ArcticMeteor246/Annex-Engineering_User_Mods/Extruders/Ascender/churls-Ball_bearing_latch/Images/ISO.png

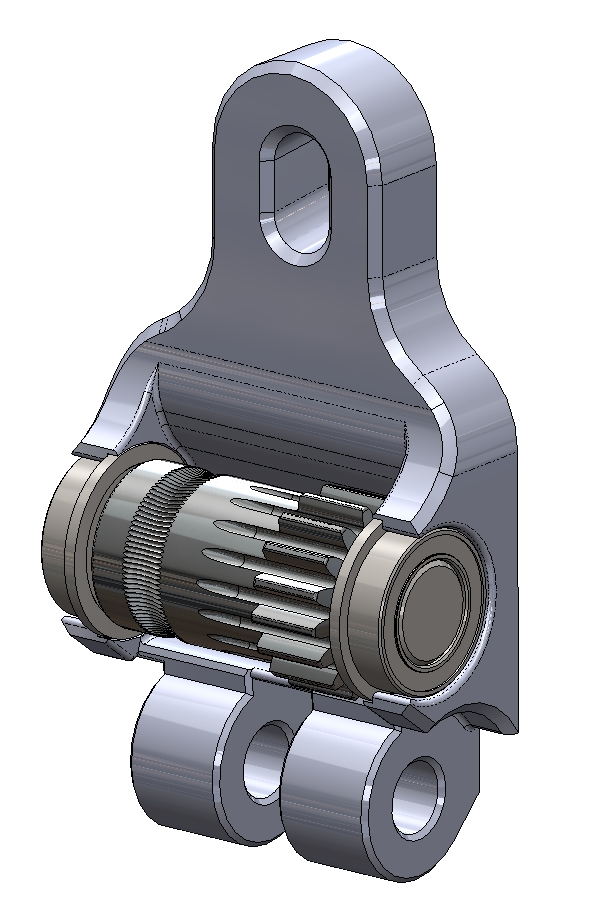
Extruders/Ascender/churls-Ball_bearing_latch/Images/ISO.png
