ArcticMeteor246/Annex-Engineering_User_Mods/Extruders/Ascender/churls-Fixed_idler_ascender/Images/ISO.png

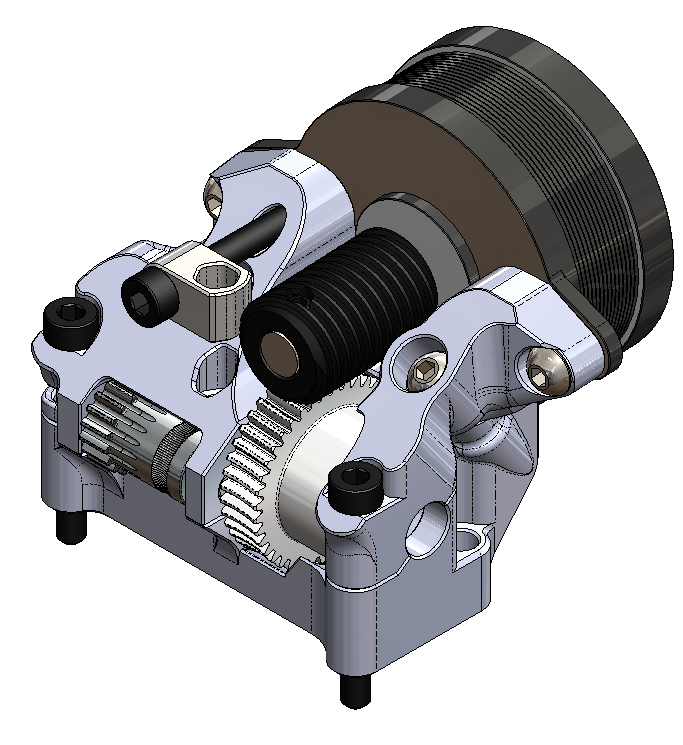
Extruders/Ascender/churls-Fixed_idler_ascender/Images/ISO.png
