ArcticMeteor246/Annex-Engineering_User_Mods/Extruders/Ascender/churls-Fixed_idler_ascender/Images/ISO_MR85.png

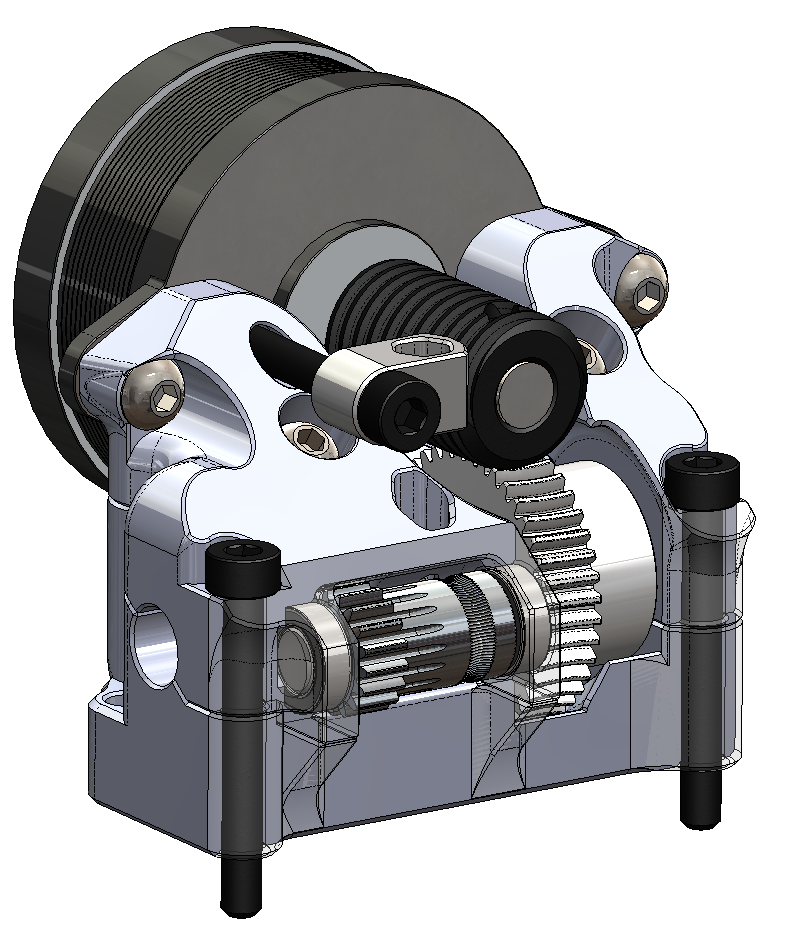
Extruders/Ascender/churls-Fixed_idler_ascender/Images/ISO_MR85.png
