ArcticMeteor246/Annex-Engineering_User_Mods/Extruders/Sherpa_Micro/Extruder_Mods/Churls_Fixed_Idler_Micro/Images/vzISO.png

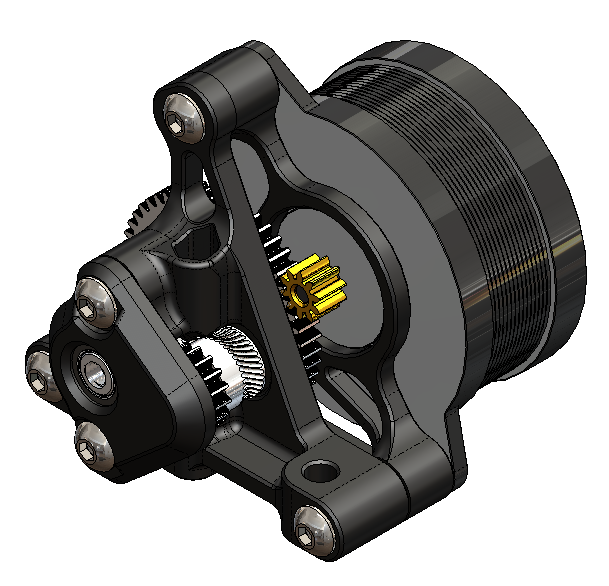
Extruders/Sherpa_Micro/Extruder_Mods/Churls_Fixed_Idler_Micro/Images/vzISO.png
