ArcticMeteor246/Annex-Engineering_User_Mods/Extruders/Sherpa_Mini/Extruder_Mods/Churls-Fixed_Idler_Mini/Images/vzISO.png

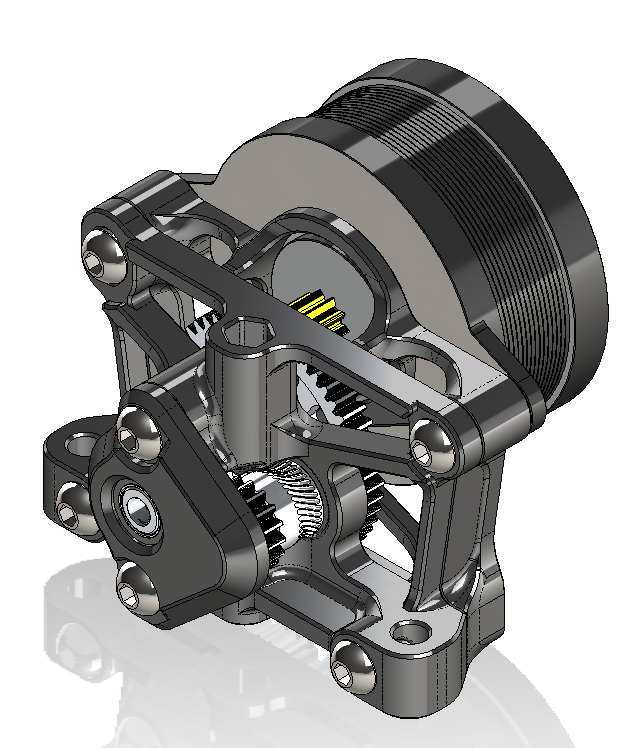
Extruders/Sherpa_Mini/Extruder_Mods/Churls-Fixed_Idler_Mini/Images/vzISO.png
