ArcticMeteor246/Annex-Engineering_User_Mods/Extruders/Sherpa_Mini/Toolheads/Churls-Chubby_E3/Images/Chubby+QuickDraw.png

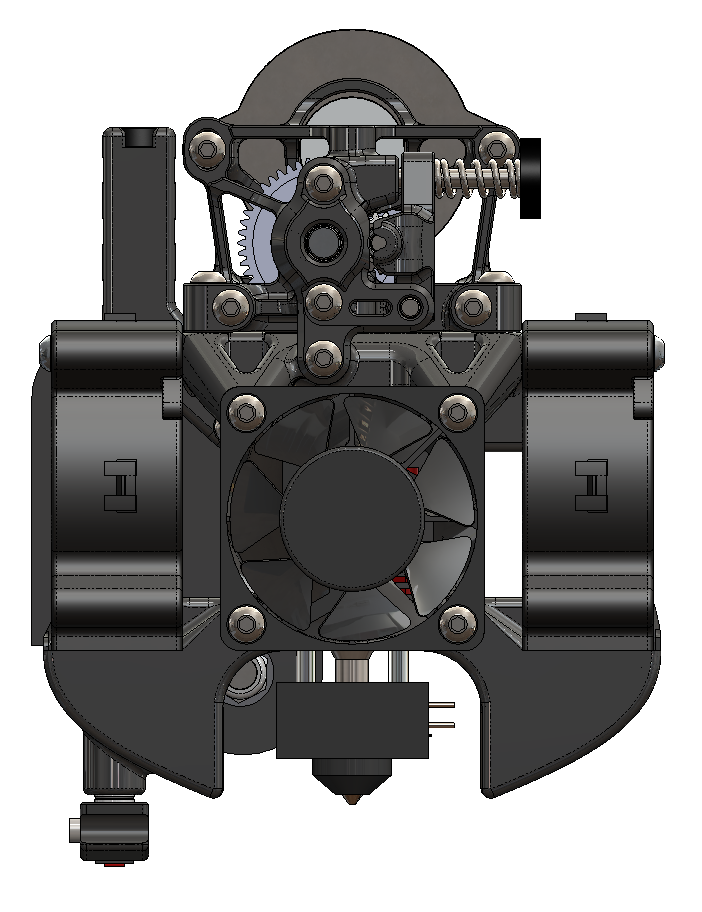
Extruders/Sherpa_Mini/Toolheads/Churls-Chubby_E3/Images/Chubby+QuickDraw.png
