ArcticMeteor246/Annex-Engineering_User_Mods/Extruders/Sherpa_Mini/Toolheads/Churls-Stiffy_E3/Images/QuickDraw_XY_Offset.png

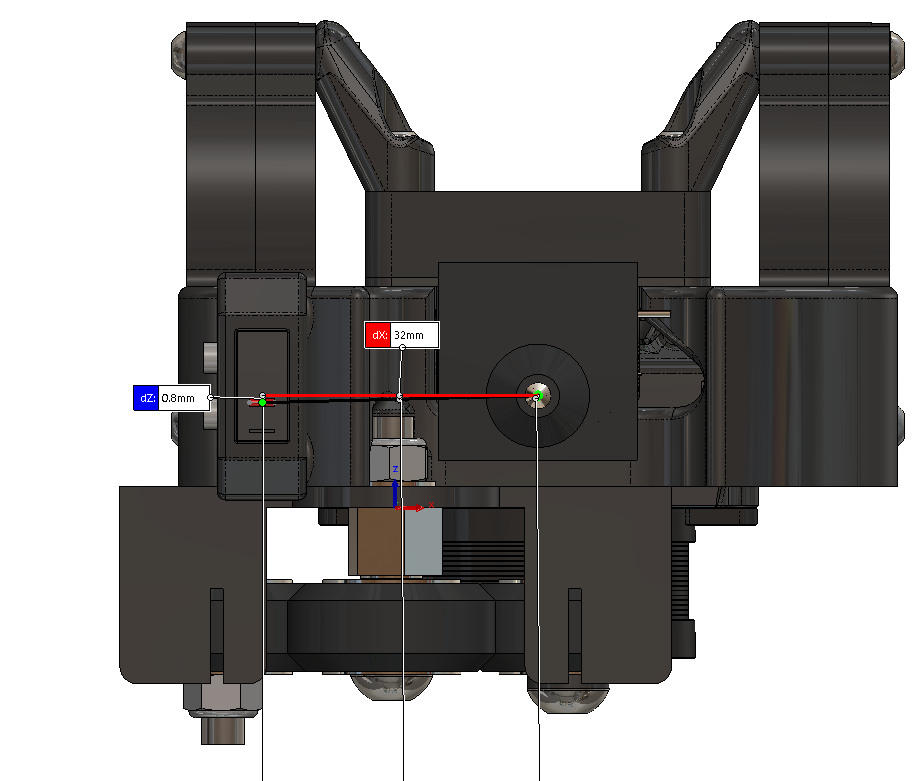
Extruders/Sherpa_Mini/Toolheads/Churls-Stiffy_E3/Images/QuickDraw_XY_Offset.png
