ArcticMeteor246/Annex-Engineering_User_Mods/Extruders/Ascender/churls-Ball_bearing_latch/CAD/mr85_ascender_latch.STEP

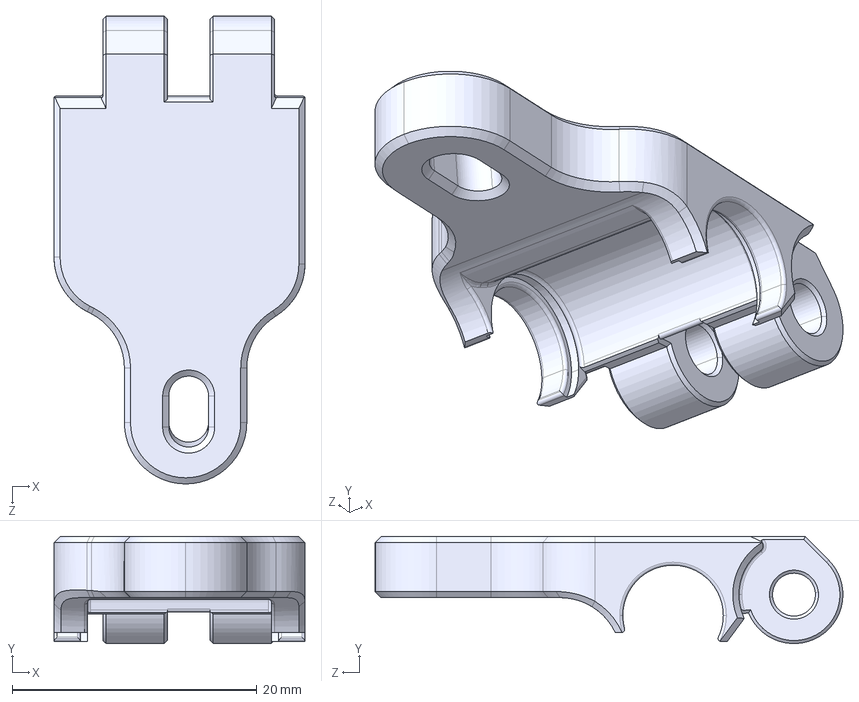
[picture p20: CAD file, 2023-04-30]
Extruders/Ascender/churls-Ball_bearing_latch/CAD/mr85_ascender_latch.STEP
20.5 x 8.74 x 38.2 mm
