ArcticMeteor246/Annex-Engineering_User_Mods/Extruders/Sherpa_Micro/Extruder_Mods/Churls_Fixed_Idler_Micro/STLs/Bondtech RIDGA/Sherpa_micro_housing_front.STL

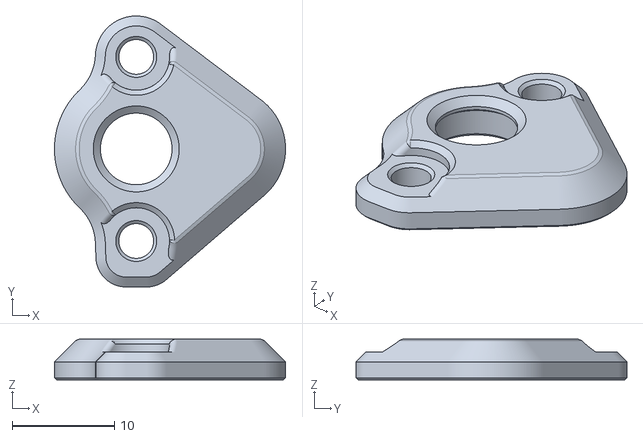
[picture p21: CAD file, 2023-04-30]
Extruders/Sherpa_Micro/Extruder_Mods/Churls_Fixed_Idler_Micro/STLs/Bondtech RIDGA/Sherpa_micro_housing_front.STL
22.6 x 26.5 x 4.00
