ArcticMeteor246/Annex-Engineering_User_Mods/Extruders/Sherpa_Micro/Extruder_Mods/Churls_Micro_RIDGA/STLs/Mellow vzRIDGA/Sherpa_micro_housing_front.STL

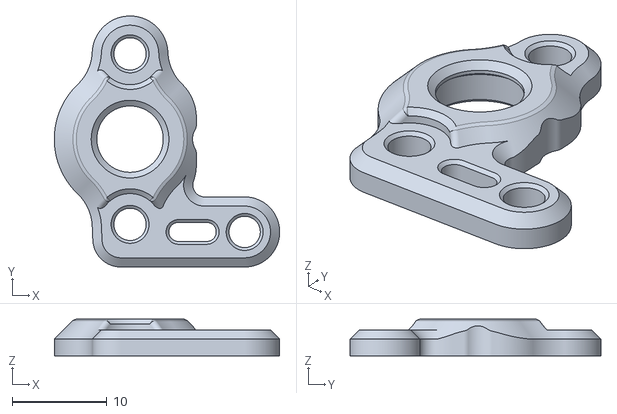
[picture p22: CAD file, 2023-04-30]
Extruders/Sherpa_Micro/Extruder_Mods/Churls_Micro_RIDGA/STLs/Mellow vzRIDGA/Sherpa_micro_housing_front.STL
23.8 x 26.5 x 3.90
