ArcticMeteor246/Annex-Engineering_User_Mods/Extruders/Sherpa_Mini/Extruder_Mods/Churls-Mini_RIDGA/STLs/Bondtech RIDGA/Additional Parts for 4x7x2.5 Bearings/RIDGA_Sherpa_housing_front_4x7x2.5_BRG.STL

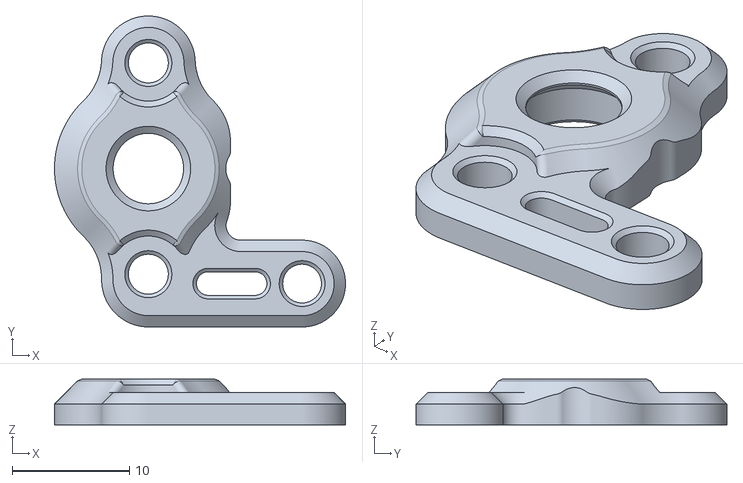
[picture p23: CAD file, 2023-04-30]
Extruders/Sherpa_Mini/Extruder_Mods/Churls-Mini_RIDGA/STLs/Bondtech RIDGA/Additional Parts for 4x7x2.5 Bearings/RIDGA_Sherpa_housing_front_4x7x2.5_BRG.STL
24.8 x 26.5 x 3.90
