ArcticMeteor246/Annex-Engineering_User_Mods/Extruders/Sherpa_Mini/Extruder_Mods/Churls-Mini_RIDGA/STLs/Bondtech RIDGA/Additional Parts for 4x8x3 Bearings/RIDGA_sherpa_mini_housing_front_k_4x8x3_BRG.STL

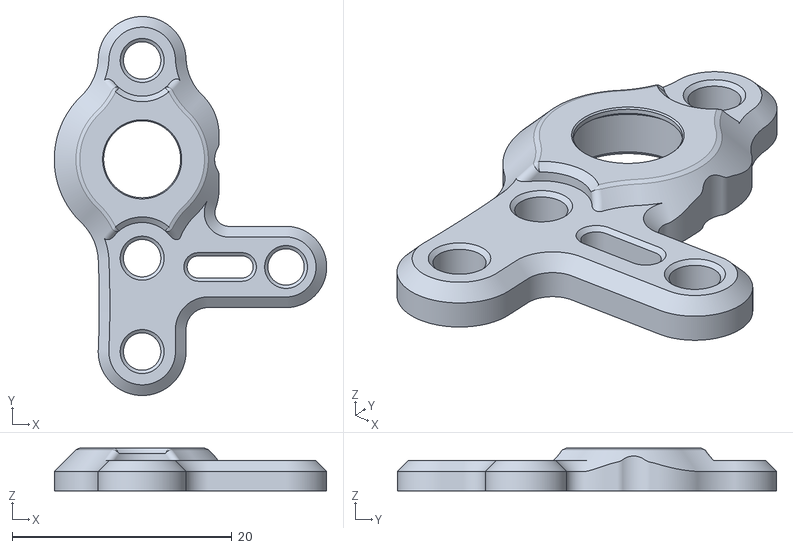
[picture p24: CAD file, 2023-04-30]
Extruders/Sherpa_Mini/Extruder_Mods/Churls-Mini_RIDGA/STLs/Bondtech RIDGA/Additional Parts for 4x8x3 Bearings/RIDGA_sherpa_mini_housing_front_k_4x8x3_BRG.STL
24.8 x 34.5 x 3.90
