ArcticMeteor246/Annex-Engineering_User_Mods/Extruders/Sherpa_Mini/Toolheads/Churls-Chubby_E3/CAD/Chubby.STEP

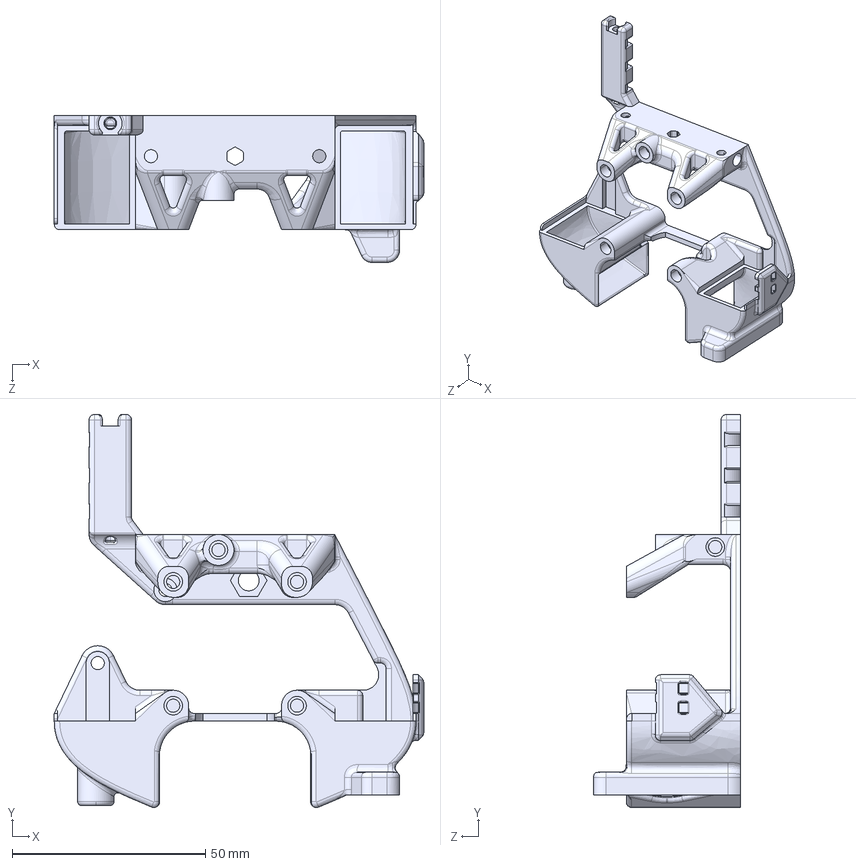
[picture p25: CAD file, 2023-04-30]
Extruders/Sherpa_Mini/Toolheads/Churls-Chubby_E3/CAD/Chubby.STEP
95.5 x 101.6 x 37.9 mm
