ArcticMeteor246/Annex-Engineering_User_Mods/Printers/K3/chkockle-Nozzle_Wiper_Beacon/CAD/Beacon_NozzleWiper.step

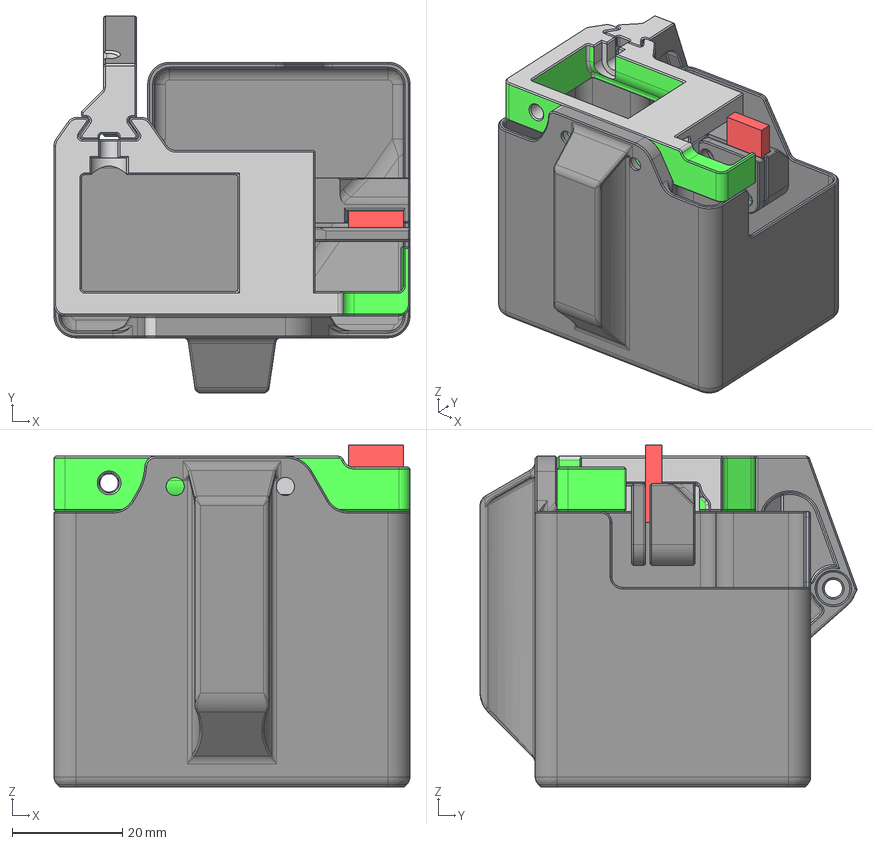
[picture p26: CAD file, 2023-04-30]
Printers/K3/chkockle-Nozzle_Wiper_Beacon/CAD/Beacon_NozzleWiper.step
64.6 x 68.4 x 62.0 mm
Nozzle Wiper Bracket V2^K3 Sherpa Mini Toolhead
6x3_Magnet x 10
Optional Thermistor
socket head cap screw_am(B18.3.1M - 3 x 0.5 x 8 Hex SHCS -- 8NHX) x 9
socket head cap screw_am(B18.3.1M - 3 x 0.5 x 30 Hex SHCS -- 18NHX)
socket button head cap screw_am(B18.3.4M - 3 x 0.5 x 8 SBHCS --N) x 2
socket head cap screw_am(B18.3.1M - 3 x 0.5 x 10 Hex SHCS -- 10NHX) x 3
socket head cap screw_am(B18.3.1M - 3 x 0.5 x 12 Hex SHCS -- 12NHX) x 3
socket head cap screw_am(B18.3.1M - 3 x 0.5 x 25 Hex SHCS -- 18NHX) x 2
94180A331_HEAT-SET INSERTS FOR PLASTICS x 13
93625A100_18-8 STAINLESS STEEL NYLON-INSERT LOCKNUT
Nozzle Wiper Base^K3 Sherpa Mini Toolhead
Nozzle Wiper Arm^K3 Sherpa Mini Toolhead
Nozzle Wiper Arm^K3 Sherpa Mini Toolhead (1)
Nozzle Wiper Arm^K3 Sherpa Mini Toolhead (2)
Purge Bucket V2^K3 Sherpa Mini Toolhead
