ArcticMeteor246/Annex-Engineering_User_Mods/Printers/K3/chkockle-Nozzle_Wiper_Beacon/STLs/Nozzle_Wiper_Arm_Beacon.stl

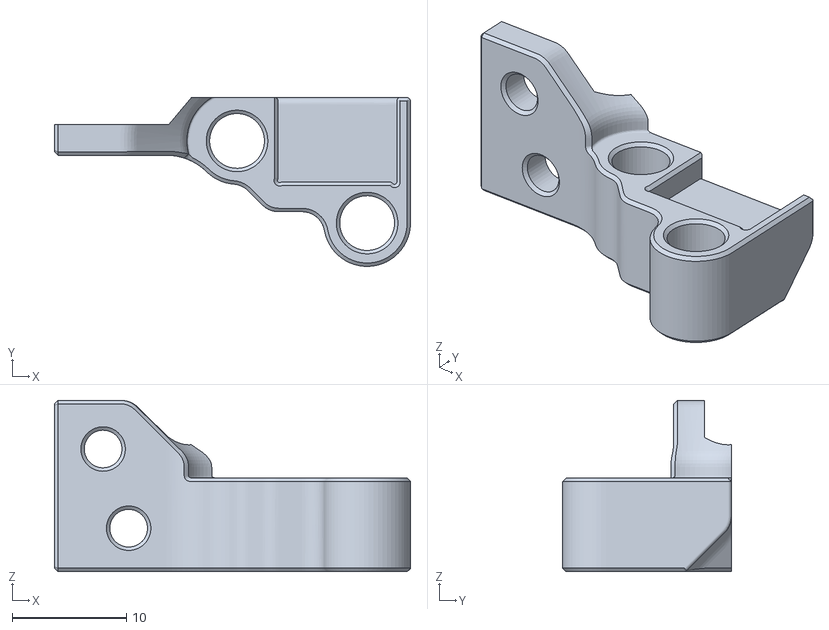
[picture p27: CAD file, 2023-04-30]
Printers/K3/chkockle-Nozzle_Wiper_Beacon/STLs/Nozzle_Wiper_Arm_Beacon.stl
31.2 x 14.8 x 15.0
