ArcticMeteor246/Annex-Engineering_User_Mods/Printers/K3/Healthier-90mm_Door_Seal_And_LED-Bars/CAD/DoorSealAndLights.step

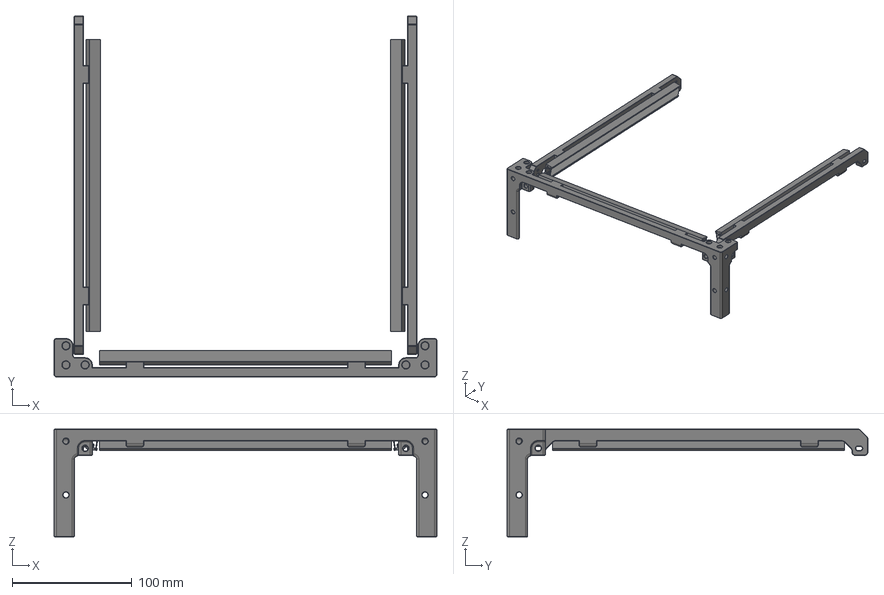
[picture p28: CAD file, 2023-04-30]
Printers/K3/Healthier-90mm_Door_Seal_And_LED-Bars/CAD/DoorSealAndLights.step
320.0 x 301.4 x 90.0 mm
LEDMounts
RightBar
LeftBar
FrontBar
