ArcticMeteor246/Annex-Engineering_User_Mods/Printers/K3/Healthier-90mm_Door_Seal_And_LED-Bars/STLs/FrontMountAndDoorSeal.stl

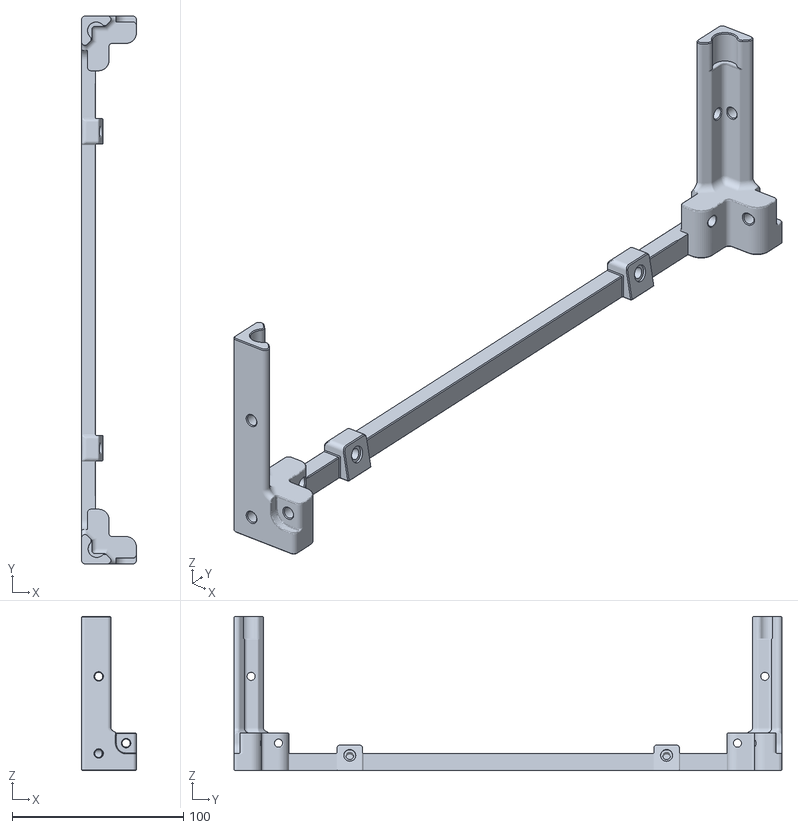
[picture p29: CAD file, 2023-04-30]
Printers/K3/Healthier-90mm_Door_Seal_And_LED-Bars/STLs/FrontMountAndDoorSeal.stl
32.0 x 320.0 x 90.0
