ArcticMeteor246/Annex-Engineering_User_Mods/Printers/K3/Healthier-K3_DFA_Carabiner_Mount/CAD/K3_DFA_Carabiner_Mount.step

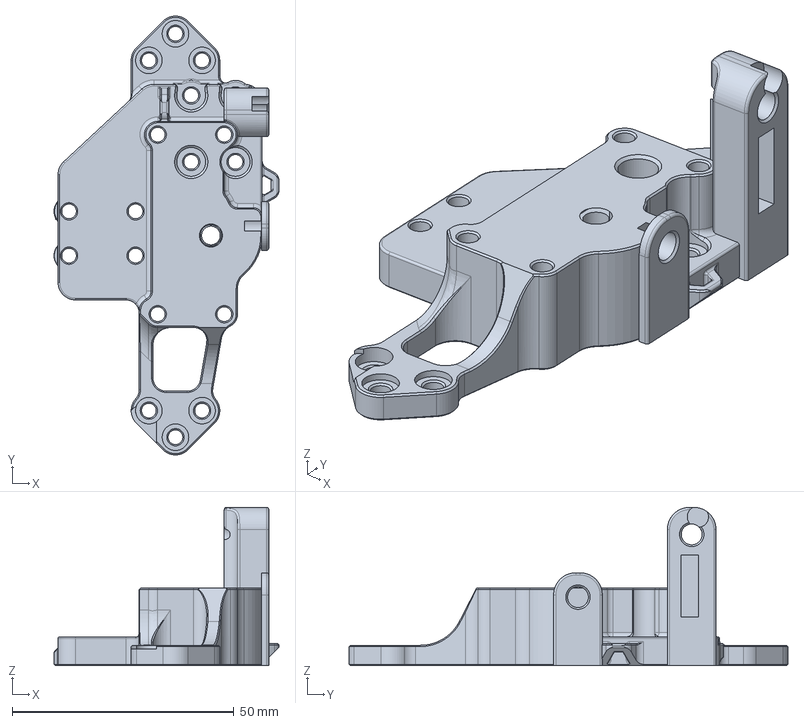
[picture p30: CAD file, 2023-04-30]
Printers/K3/Healthier-K3_DFA_Carabiner_Mount/CAD/K3_DFA_Carabiner_Mount.step
50.7 x 99.0 x 35.7 mm
