ArcticMeteor246/Annex-Engineering_User_Mods/Printers/K3/long-Pi_Cam_v3_Mount/CAD/PiCam3 Mount v43.step

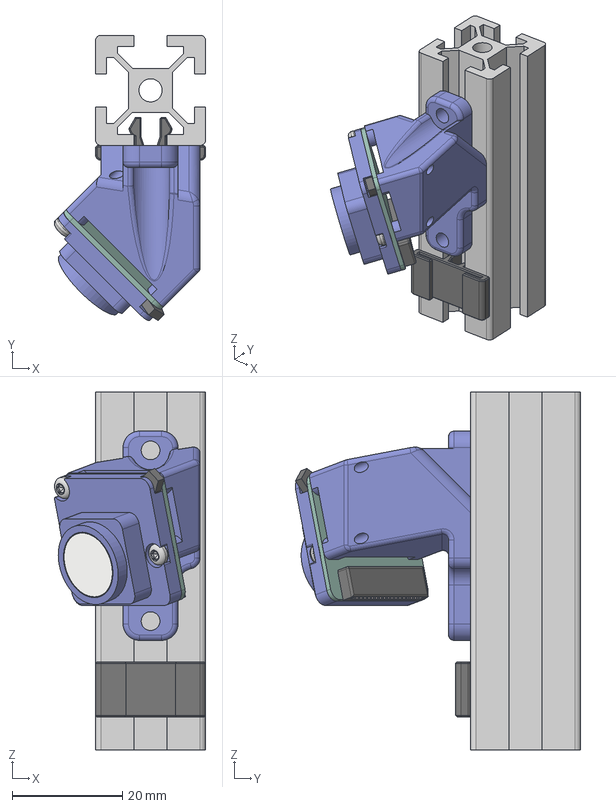
[picture p31: CAD file, 2023-04-30]
Printers/K3/long-Pi_Cam_v3_Mount/CAD/PiCam3 Mount v43.step
27.5 x 51.8 x 65.0 mm
Mount
Ribbon Holder
PiCam 3
Camera Cover
90362A138_18-8 Stainless Steel Pan Head Torx Screws x 4
