ArcticMeteor246/Annex-Engineering_User_Mods/Printers/K3/long-Pi_Cam_v3_Mount/STLs/Pi Cam 3 Mount - Mount - 25 degree down.stl

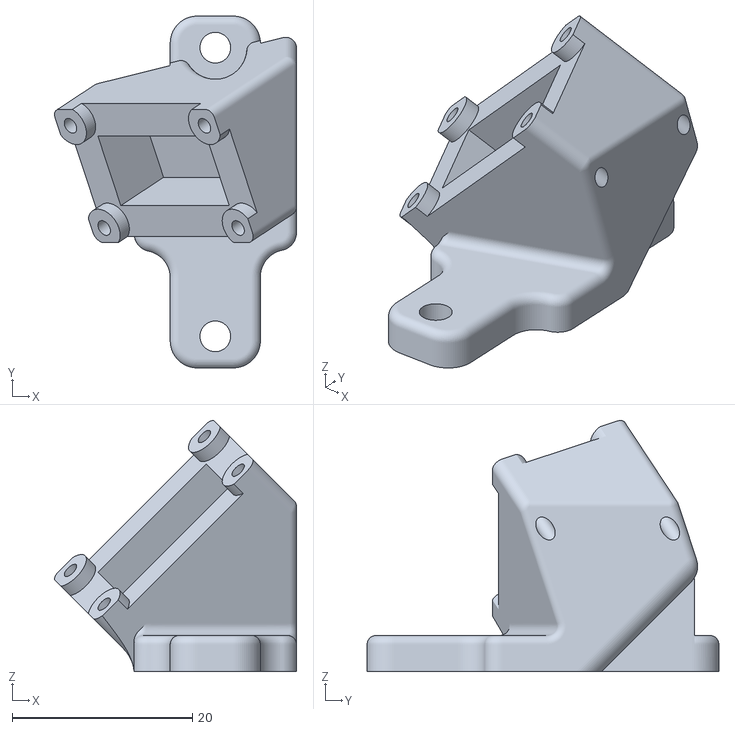
[picture p32: CAD file, 2023-04-30]
Printers/K3/long-Pi_Cam_v3_Mount/STLs/Pi Cam 3 Mount - Mount - 25 degree down.stl
26.8 x 39.0 x 27.8
