ArcticMeteor246/Annex-Engineering_User_Mods/Printers/K3/long-right_side_PTFE_tube_guide/STLs/Spacer_2mm.stl

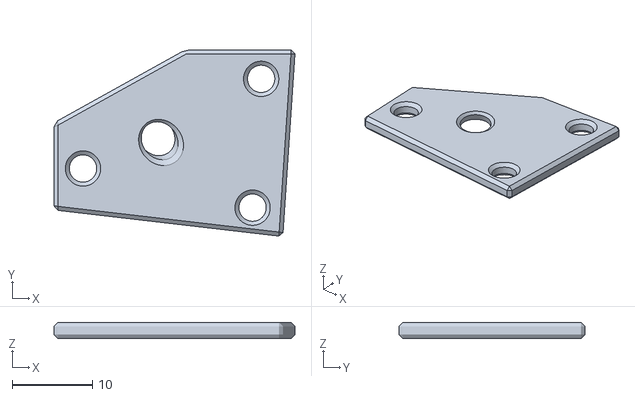
[picture p33: CAD file, 2023-04-30]
Printers/K3/long-right_side_PTFE_tube_guide/STLs/Spacer_2mm.stl
30.0 x 23.2 x 2.00
