ArcticMeteor246/Annex-Engineering_User_Mods/Printers/Non_Annex_Printers/VORON_Printers/VORON_V2dot4/MRO_Reinforced_Gantry_Mounts/CAD/MRO_z_bearing_block_20mm.stp

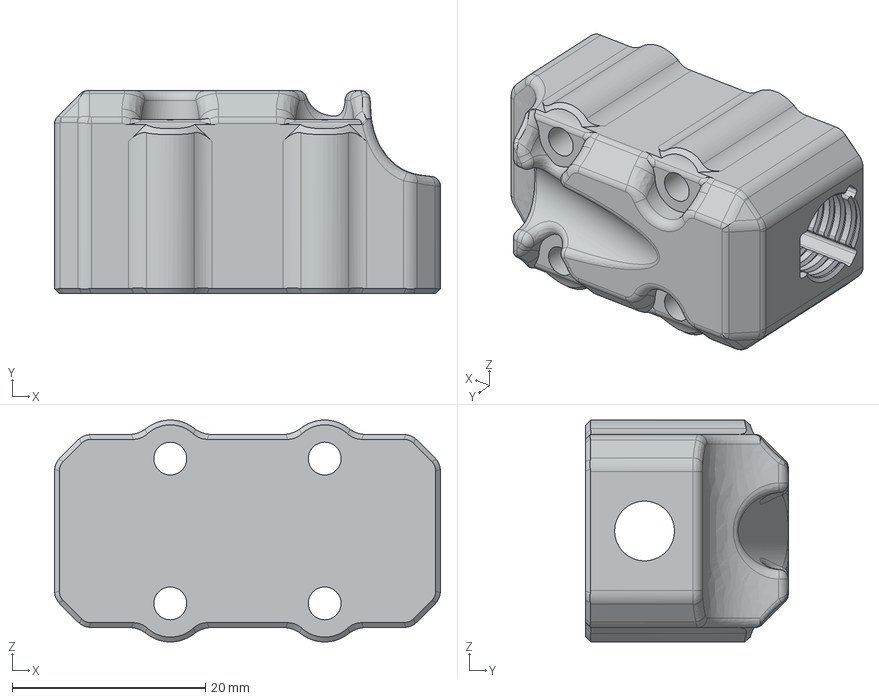
[picture p34: CAD file, 2023-04-30]
Printers/Non_Annex_Printers/VORON_Printers/VORON_V2dot4/MRO_Reinforced_Gantry_Mounts/CAD/MRO_z_bearing_block_20mm.stp
40.0 x 21.0 x 23.0 mm
