ArcticMeteor246/Annex-Engineering_User_Mods/Extruders/Sherpa_Micro/Extruder_Mods/Churls_Fixed_Idler_Micro/STLs/Bondtech RIDGA/Sherpa_micro_housing_rear.STL

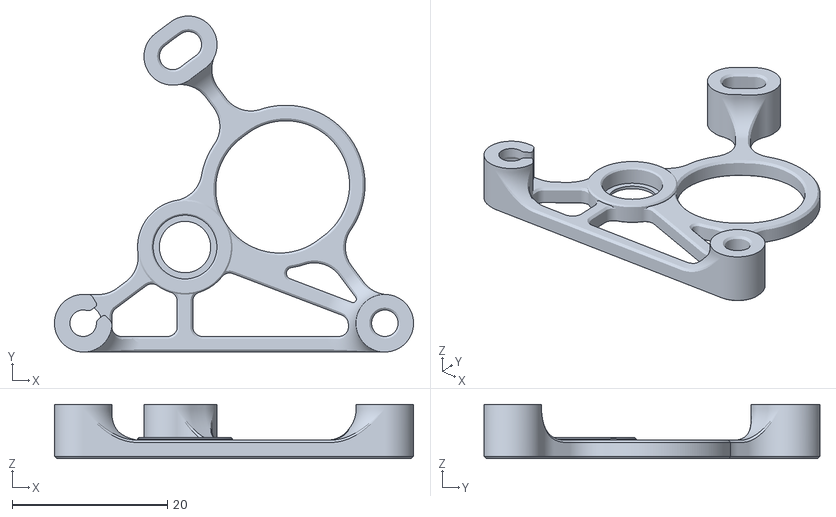
[picture p35: CAD file, 2023-04-30]
Extruders/Sherpa_Micro/Extruder_Mods/Churls_Fixed_Idler_Micro/STLs/Bondtech RIDGA/Sherpa_micro_housing_rear.STL
46.2 x 43.2 x 7.00
