ArcticMeteor246/Annex-Engineering_User_Mods/Printers/K3/chkockle-Nozzle_Wiper_Beacon/STLs/Purge_Bucket_Beacon.stl

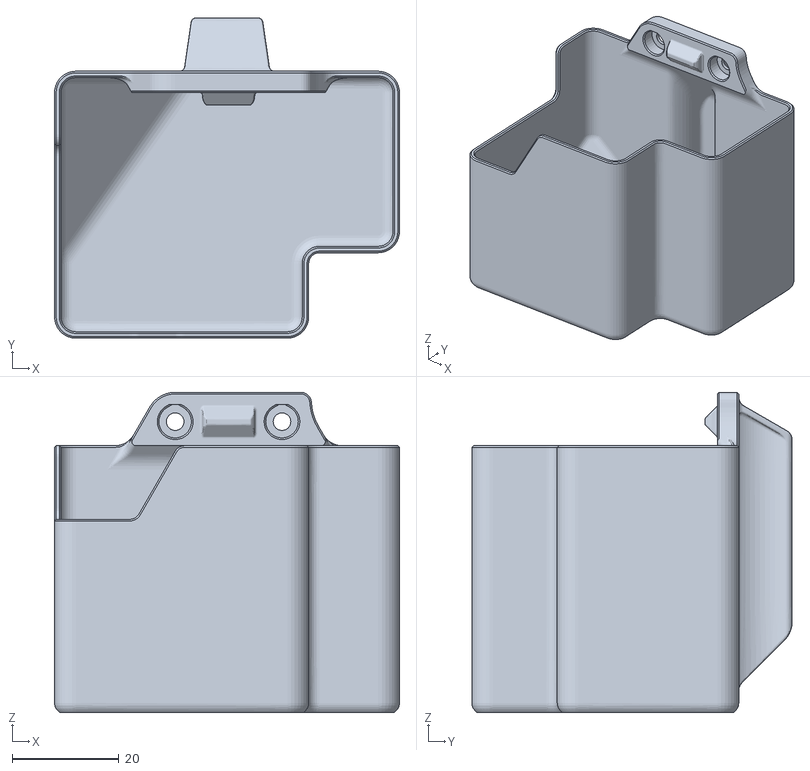
[picture p37: CAD file, 2023-04-30]
Printers/K3/chkockle-Nozzle_Wiper_Beacon/STLs/Purge_Bucket_Beacon.stl
64.6 x 60.0 x 60.0
