ArcticMeteor246/Annex-Engineering_User_Mods/Printers/K3/Healthier-90mm_Door_Seal_And_LED-Bars/STLs/Diffuser_x3.stl

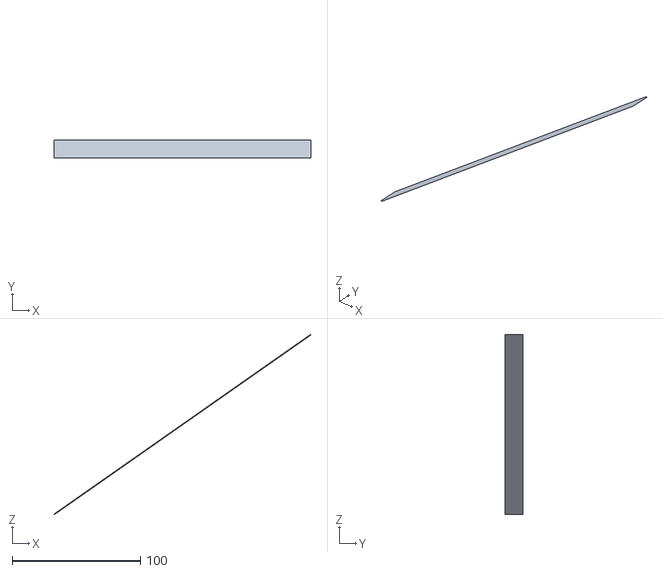
[picture p38: CAD file, 2023-04-30]
Printers/K3/Healthier-90mm_Door_Seal_And_LED-Bars/STLs/Diffuser_x3.stl
200.2 x 14.1 x 140.4
