ArcticMeteor246/Annex-Engineering_User_Mods/Printers/K3/long-Pi_Cam_v3_Mount/STLs/Pi Cam 3 Mount - Ribbon Holder - Tighter v3.stl

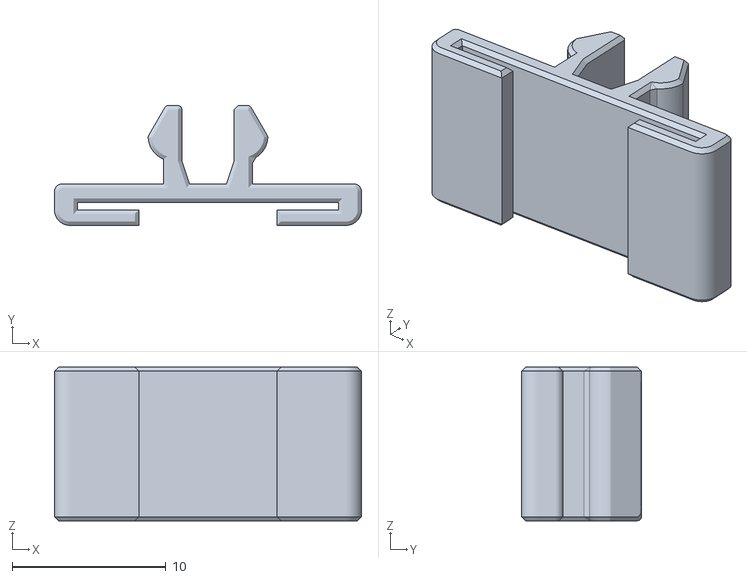
[picture p39: CAD file, 2023-04-30]
Printers/K3/long-Pi_Cam_v3_Mount/STLs/Pi Cam 3 Mount - Ribbon Holder - Tighter v3.stl
20.0 x 7.80 x 10.0
