ArcticMeteor246/Annex-Engineering_User_Mods/Printers/K3/chkockle-Nozzle_Wiper_Beacon/STLs/Nozzle_Wiper_Base_Beacon.stl

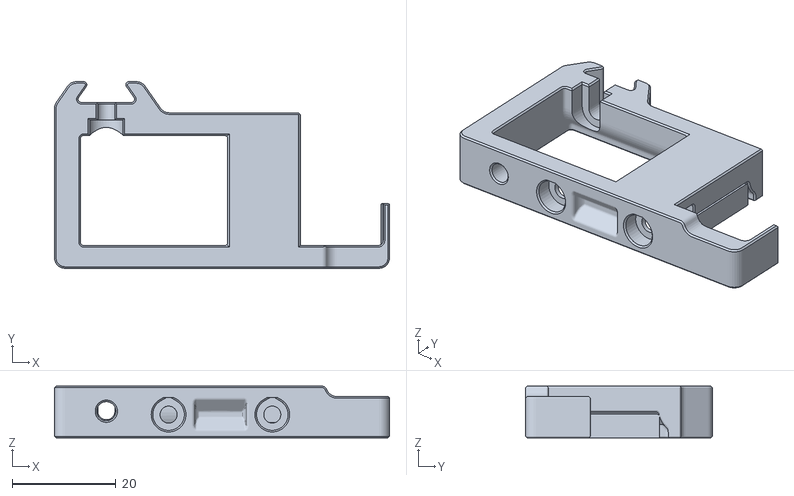
[picture p40: CAD file, 2023-04-30]
Printers/K3/chkockle-Nozzle_Wiper_Beacon/STLs/Nozzle_Wiper_Base_Beacon.stl
64.6 x 36.0 x 10.00
