ArcticMeteor246/Annex-Engineering_User_Mods/Printers/K3/Healthier-90mm_Door_Seal_And_LED-Bars/STLs/SideMount_x2.stl

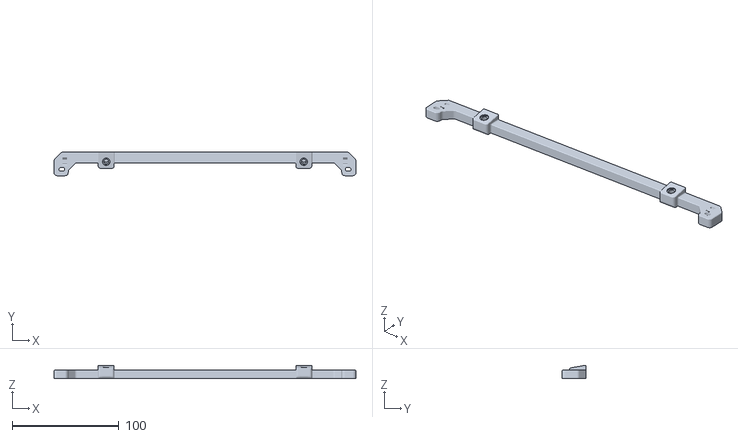
[picture p41: CAD file, 2023-04-30]
Printers/K3/Healthier-90mm_Door_Seal_And_LED-Bars/STLs/SideMount_x2.stl
282.7 x 22.0 x 12.6
