ArcticMeteor246/Annex-Engineering_User_Mods/Printers/K3/long-Pi_Cam_v3_Mount/STLs/Pi Cam 3 Mount - Lens Cover - 12.4mm Lens.stl

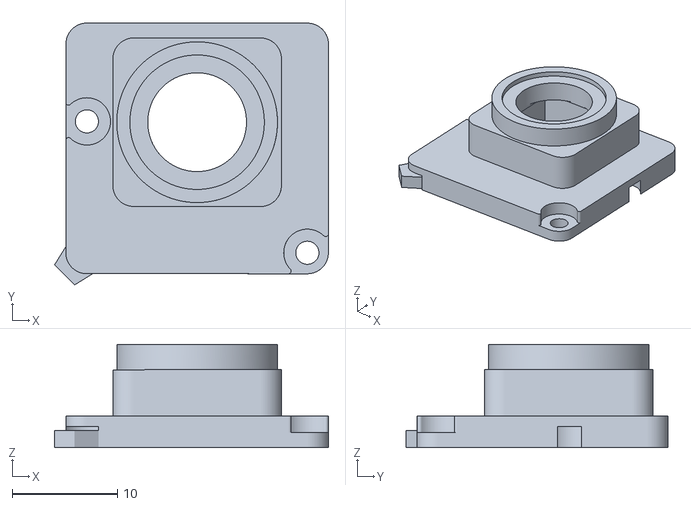
[picture p42: CAD file, 2023-04-30]
Printers/K3/long-Pi_Cam_v3_Mount/STLs/Pi Cam 3 Mount - Lens Cover - 12.4mm Lens.stl
26.1 x 24.9 x 9.81
