ArcticMeteor246/Annex-Engineering_User_Mods/Printers/K3/chkockle-Nozzle_Wiper_Beacon/STLs/Nozzle_Wiper_Bracket_Beacon.stl

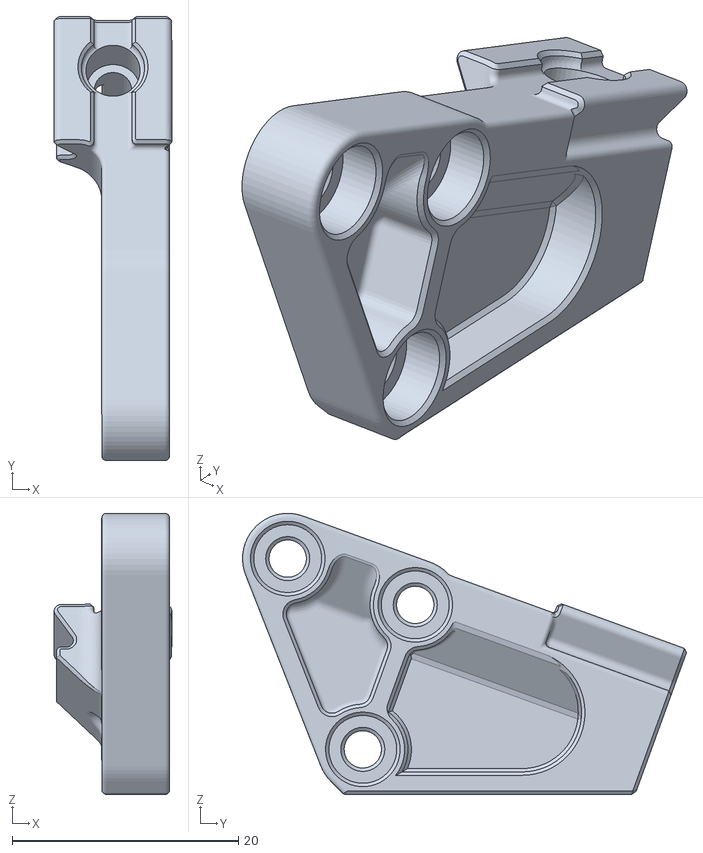
[picture p43: CAD file, 2023-04-30]
Printers/K3/chkockle-Nozzle_Wiper_Beacon/STLs/Nozzle_Wiper_Bracket_Beacon.stl
10.4 x 39.3 x 24.9
