ArcticMeteor246/Annex-Engineering_User_Mods/Printers/K3/Healthier-90mm_Door_Seal_And_LED-Bars/STLs/LEDHolder_x3.stl

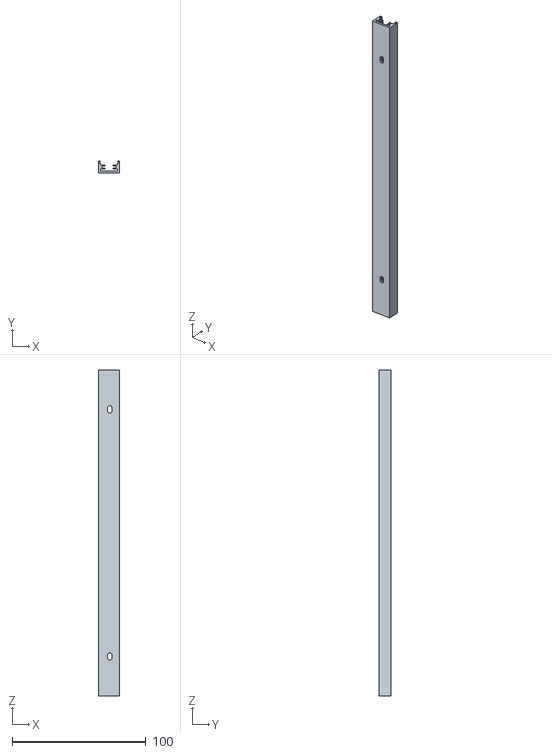
[picture p44: CAD file, 2023-04-30]
Printers/K3/Healthier-90mm_Door_Seal_And_LED-Bars/STLs/LEDHolder_x3.stl
16.0 x 9.30 x 244.0
