ArcticMeteor246/Annex-Engineering_User_Mods/Printers/K3/long-Pi_Cam_v3_Mount/STLs/Pi Cam 3 Mount - Mount - 15 degree down.stl

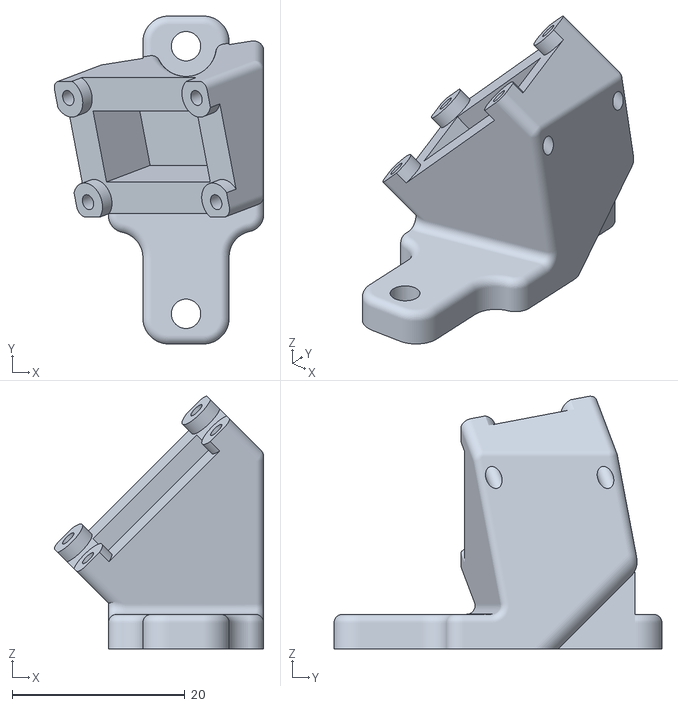
[picture p45: CAD file, 2023-04-30]
Printers/K3/long-Pi_Cam_v3_Mount/STLs/Pi Cam 3 Mount - Mount - 15 degree down.stl
24.3 x 38.0 x 29.3
