ArcticMeteor246/Annex-Engineering_User_Mods/(list of files, cad)

Other CAD files:
Extruders/Sherpa_Micro/Extruder_Mods/Churls_Fixed_Idler_Micro/STLs/Mellow VZ RIDGA/Sherpa_micro_housing_front.STL
Extruders/Sherpa_Micro/Extruder_Mods/Churls_Fixed_Idler_Micro/STLs/Standard Gears/fixed_idler_housing_front.STL
Extruders/Sherpa_Mini/Extruder_Mods/Churls-Fixed_Idler_Mini/STLs/Bondtech RIDGA/fixed_idler_housing_front.STL
Extruders/Sherpa_Mini/Extruder_Mods/Churls-Fixed_Idler_Mini/STLs/Mellow vzRIDGA/Sherpa Housing_front.STL
Extruders/Sherpa_Mini/Extruder_Mods/Churls-Fixed_Idler_Mini/STLs/Standard Gears/fixed_idler_housing_front.STL
Extruders/Sherpa_Mini/Extruder_Mods/Churls-Mini_RIDGA/STLs/Bondtech RIDGA/Additional Parts for 4x7x2.5 Bearings/RIDGA_Sherpa_housing_front_k_4x7x2.5_BRG.STL
Extruders/Sherpa_Mini/Extruder_Mods/Churls-Mini_RIDGA/STLs/Bondtech RIDGA/Additional Parts for 4x8x3 Bearings/RIDGA_sherpa_mini_housing_front_4x8x3_BRG.STL
Printers/K3/long-Pi_Cam_v3_Mount/STLs/Pi Cam 3 Mount - Lens Cover - 12.0mm Lens.stl
Extruders/Sherpa_Mini/Toolheads/Churls-Chubby_E3/CAD/Chubby.x_t
Extruders/Sherpa_Mini/Toolheads/Churls-Stiffy_E3/CAD/Stiffy.x_t
Printers/K3/Healthier-K3_DFA_Carabiner_Mount/STLs/K3_DFA_Carabiner_Mount.stl
Printers/K3/Outdated/Ericsson-K3_blanking_plate_logo_dualcolor/STLs/[a]logo.stl
Printers/K3/Outdated/Ericsson-K3_blanking_plate_logo_dualcolor/STLs/electronics_box_blanking_plate_with_logo.stl
Printers/K3/Outdated/Exsencer-K3_USB_Bowden_HourCounter_Plate/CAD/Electronics_Box_Blanking_Plate_Combo.step
Printers/K3/Outdated/Exsencer-K3_USB_Bowden_HourCounter_Plate/STLs/Electronics_Box_Blanking_Plate_Combo.stl
Printers/K3/Outdated/airox-backpack-rpi-camera/STLs/mount.stl
Printers/K3/Outdated/airox-blanking-plates/STLs/double-keystones-ptfe-holder.stl
Printers/K3/Outdated/airox-blanking-plates/STLs/double-keystones.stl
Printers/K3/Outdated/airox-blanking-plates/STLs/screen-ssh1106-oled-1.3.stl
Printers/K3/Outdated/amp-man-ohmite_af-c10-sd_Power_Inlet_Plate/STLs/cover_ohmite_af_c10_sd.stl
Printers/K3/Outdated/dvorak74-Magnetic_Backpack_Cover/CAD/magnetic_backpack_cover.step
Printers/K3/Outdated/dvorak74-Magnetic_Backpack_Cover/STLs/[a]_cover_clip_x4.stl
Printers/K3/Outdated/dvorak74-Magnetic_Backpack_Cover/STLs/[a]_magnetic_base_x4.stl
Printers/K3/Outdated/dvorak74-Magnetic_Backpack_Cover/STLs/[a]_side_spacer_a_x2.stl
Printers/K3/Outdated/dvorak74-Magnetic_Backpack_Cover/STLs/[a]_side_spacer_b_x2.stl
Printers/K3/Outdated/dvorak74-Magnetic_Backpack_Cover/STLs/[a]_top_bottom_spacer_a_x2.stl
Printers/K3/Outdated/dvorak74-Magnetic_Backpack_Cover/STLs/[a]_top_bottom_spacer_b_x2.stl
Printers/K3/Outdated/kirby-ADXL-headers-electronics-box-panel/CAD/Electronics_Box_Blanking_Plate_ADXL_headers.SLDPRT
Printers/K3/Outdated/kirby-ADXL-headers-electronics-box-panel/STLs/Electronics_Box_Blanking_Plate_ADXL_headers.STL
Printers/K3/Outdated/kirby-right-side_PTFE_tube_guide_press_fit/CAD/right_side_bowden_guide_push_fit.SLDPRT
Printers/K3/Outdated/kirby-right-side_PTFE_tube_guide_press_fit/STLs/Inner_Cap.STL
Printers/K3/Outdated/kirby-right-side_PTFE_tube_guide_press_fit/STLs/Outer_Cap.stl
Printers/K3/Outdated/kirby-right-side_PTFE_tube_guide_press_fit/STLs/Spacer_3mm.stl
Printers/K3/Outdated/long-right_side_PTFE_tube_guide/CAD/backpack_right_side_bowden_guide.step
Printers/K3/Outdated/long-right_side_PTFE_tube_guide/STLs/Inner_Cap.stl
Printers/K3/Outdated/long-right_side_PTFE_tube_guide/STLs/Outer_Cap.stl
Printers/K3/Outdated/long-right_side_PTFE_tube_guide/STLs/Spacer_3mm.stl
Printers/K3/Outdated/nihiro-schurter_dd12_power_inlet/CAD/electronics_box_schurter_dd12_inlet.f3z
Printers/K3/Outdated/nihiro-schurter_dd12_power_inlet/STLs/electronics_box_schurter_dd12_inlet_x1.stl
Printers/K3/Outdated/tayto-K3_Hour_Counter/CAD/K3_Hour_Counter.step
Printers/K3/Outdated/tayto-K3_Hour_Counter/STLs/K3_Hour_Counter.stl
Printers/K3/long-Pi_Cam_v3_Mount/CAD/PiCam3 Mount v43.f3d
