ArcticMeteor246/Annex-Engineering_User_Mods/Printers/K3/Outdated/airox-backpack-rpi-camera/README.md

# Backpack mount for Raspberry Pi Camera

Attach the following thingiverse Raspberry Pi mount to your backpack.
https://www.thingiverse.com/thing:3809015

# Mount setup
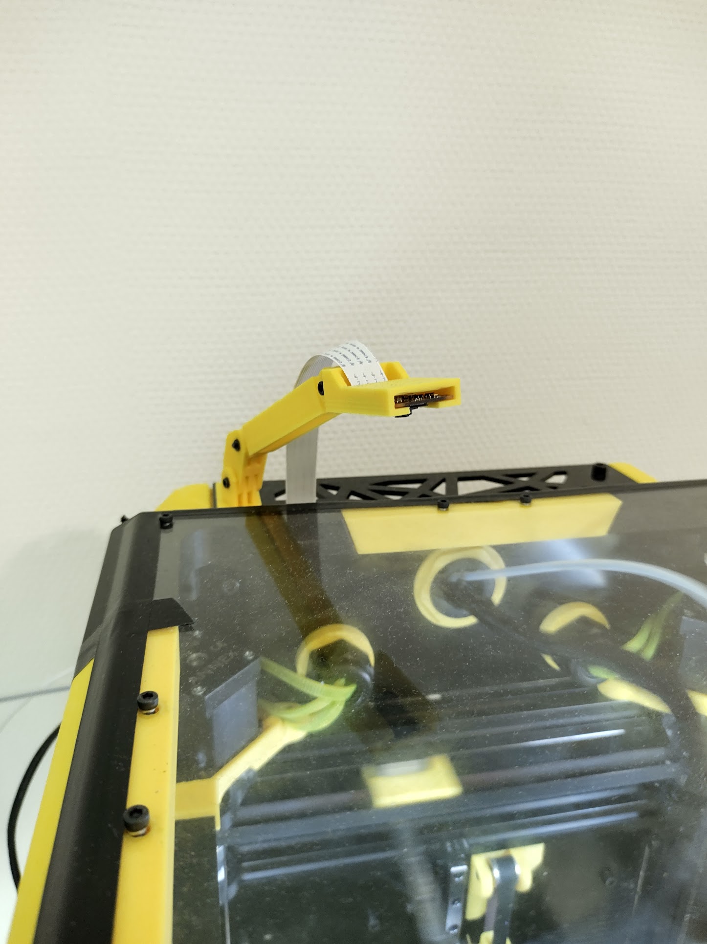
[picture p55: Printers/K3/Outdated/airox-backpack-rpi-camera/Images/mount.jpg]
