ArcticMeteor246/Annex-Engineering_User_Mods/Printers/K3/Outdated/airox-blanking-plates/README.md

# Blanking Plates

A collection of blanking plates quickly created in Tinkercad
to use on my K3. Keystones are in various sizes and types.

I used one for ethernet and USB for my Raspberry Pi.

The OLED screen are cheap to source on Amazon. You can connect them
to your spider directly or to your Raspberry Pi as MCU in klipper.

# Double keystone
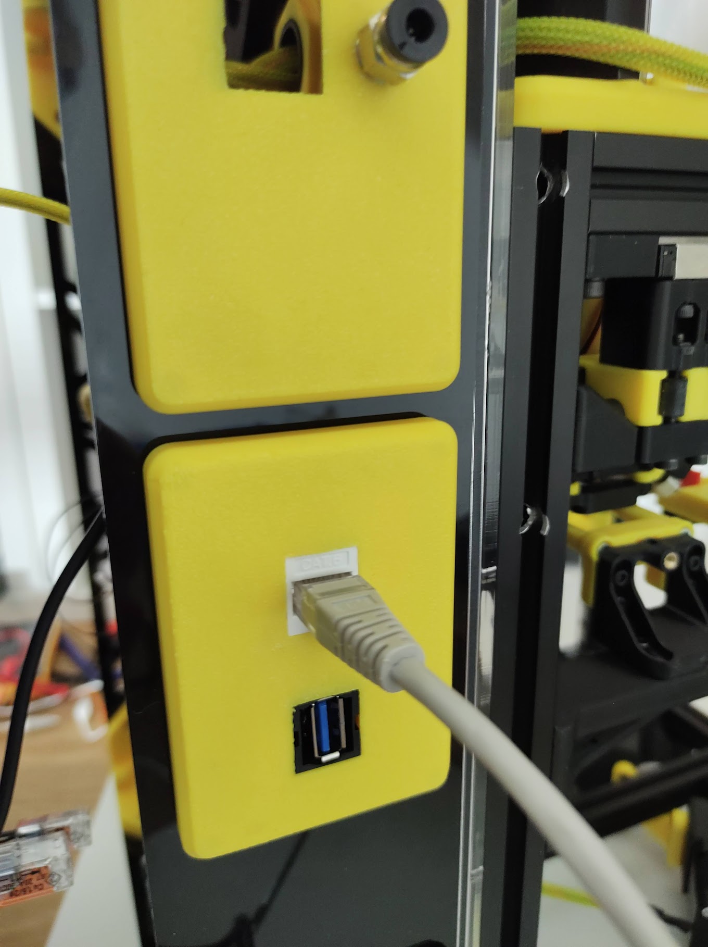
[picture p56: Printers/K3/Outdated/airox-blanking-plates/Images/double-keystones.jpg]


# Double keystone with PTFE holder
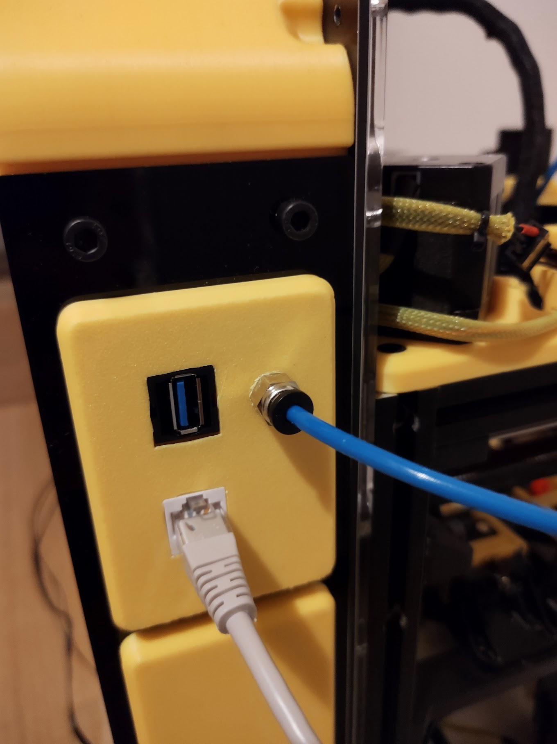
[picture p57: Printers/K3/Outdated/airox-blanking-plates/Images/double-keystones-ptfe-holder.jpg]


# SSH1106 OLED 1.3" screen
