ArcticMeteor246/Annex-Engineering_User_Mods/Printers/K3/Outdated/amp-man-ohmite_af-c10-sd_Power_Inlet_Plate/README.md

# Power Inlet Plate for Ohmite AF-C10-SD: Filtered Inlet+Switch Combo
Uses 4xM3 Heatset Insert + 2x M3x12 countersink screw.

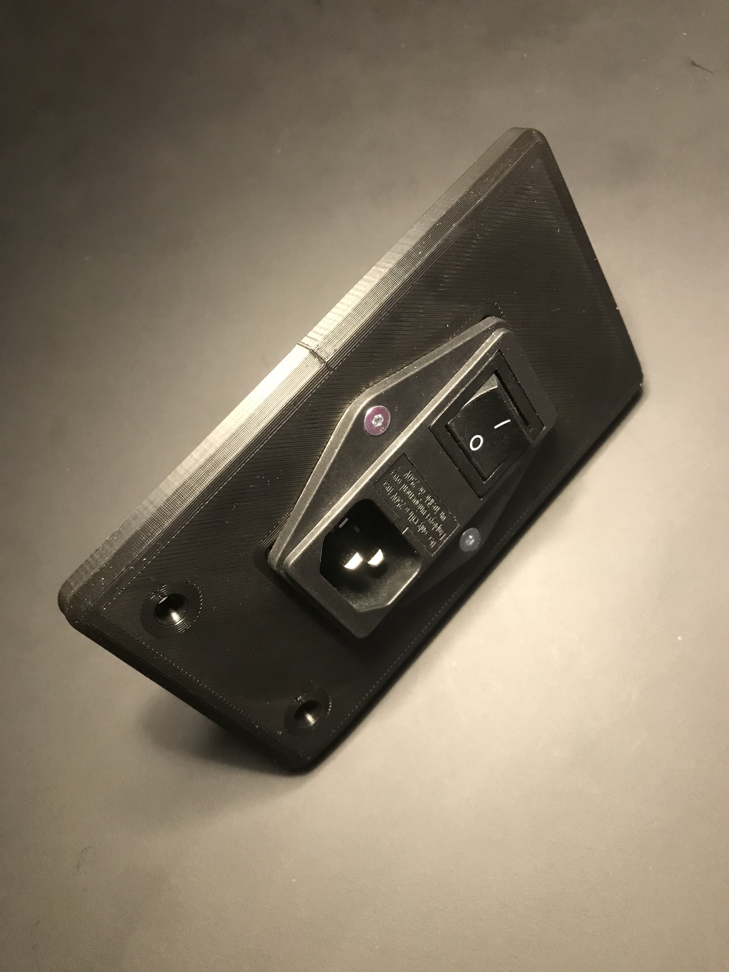
[picture p59: Printers/K3/Outdated/amp-man-ohmite_af-c10-sd_Power_Inlet_Plate/Images/front.jpeg]
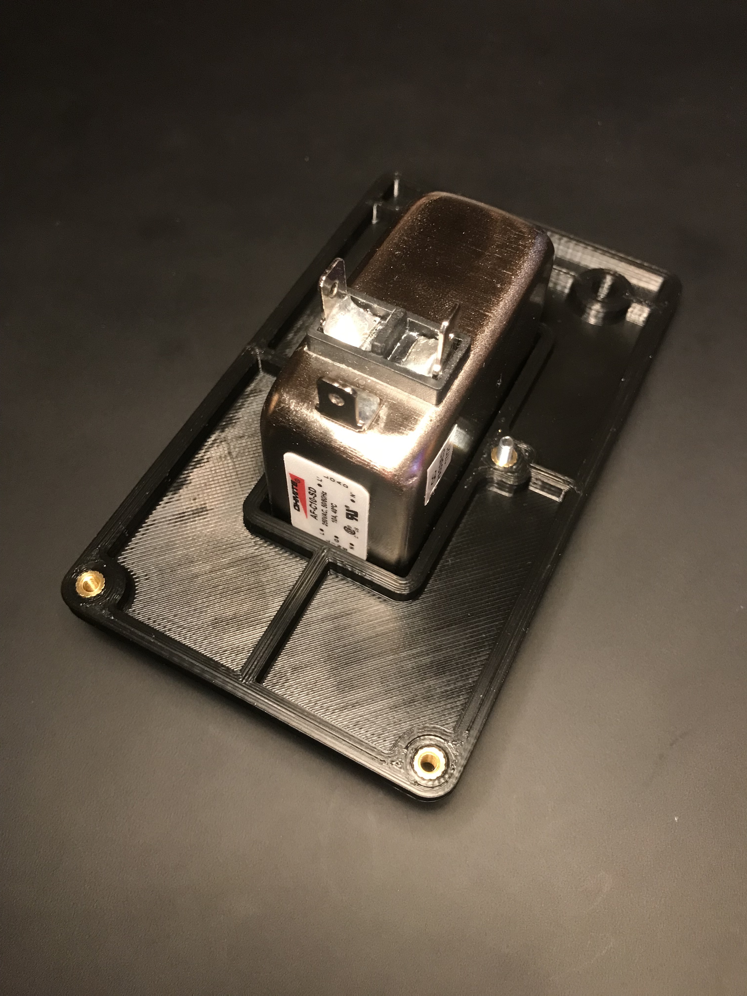
[picture p60: Printers/K3/Outdated/amp-man-ohmite_af-c10-sd_Power_Inlet_Plate/Images/back.jpeg]
