ArcticMeteor246/Annex-Engineering_User_Mods/Printers/K3/Outdated/Exsencer-K3_USB_Bowden_HourCounter_Plate/README.md

# Combo Backing Plate
A backing plate to attach an hour counter, bowden fitting, and a keystone. This is using the rectangular type hour counter and I use a usb keystone for easy IS tuning (external MCU)

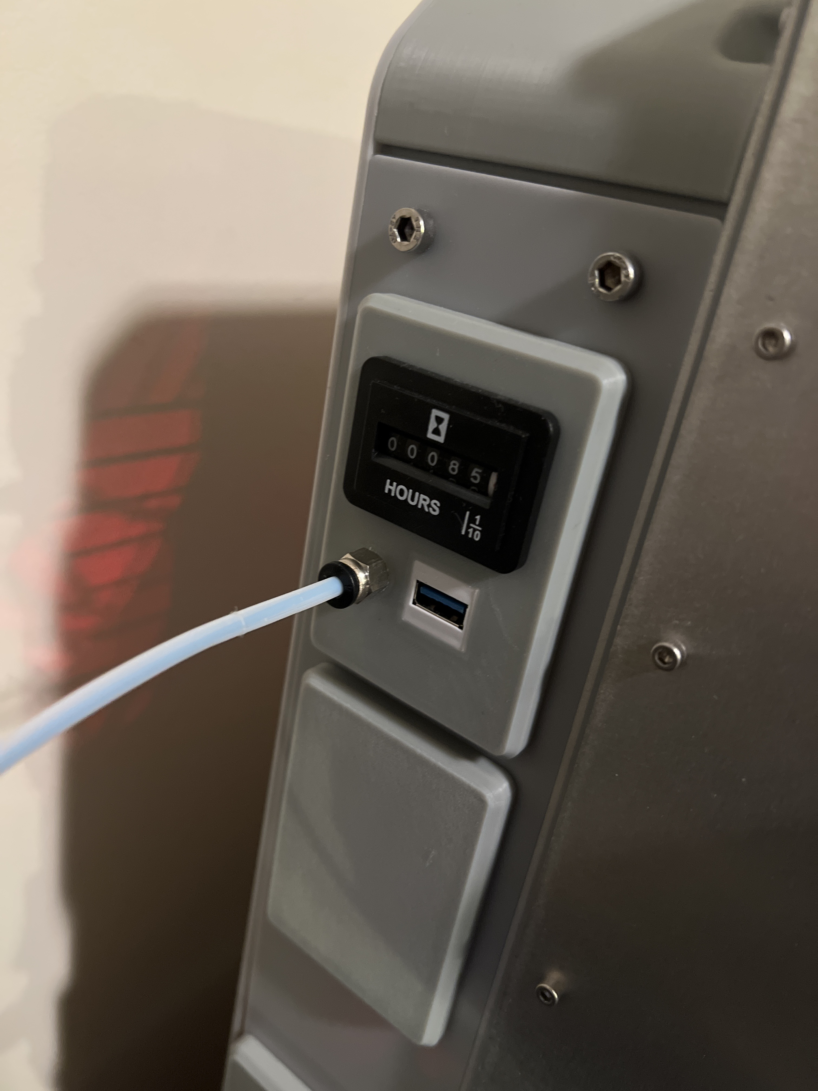
[picture p64: Printers/K3/Outdated/Exsencer-K3_USB_Bowden_HourCounter_Plate/Images/combo-plate.JPG]
