ArcticMeteor246/Annex-Engineering_User_Mods/Printers/K3/long-Pi_Cam_v3_Mount/Images/25_degree_z150.png

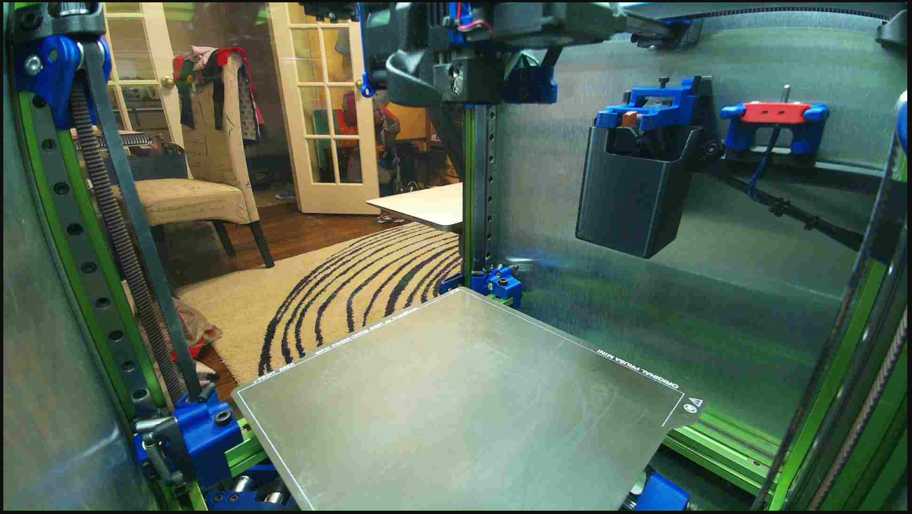
Printers/K3/long-Pi_Cam_v3_Mount/Images/25_degree_z150.png
