ArcticMeteor246/Annex-Engineering_User_Mods/(commit log)

2023-03-31 Added folder for MRO gantry mounts
2023-03-31 Added CAD and STL file, also updated the README
2023-03-31 Updated MRO gantry mounts for better printability
2023-04-30 Updated bearing blocks to go clear of M3 screw. Added screw access.
    [MRO_z_bearing_block_20mm.stp]
