ArcticMeteor246/Annex-Engineering_User_Mods/Printers/K3/Outdated/airox-blanking-plates/Images/screen-ssh1106-oled-1.3.jpg

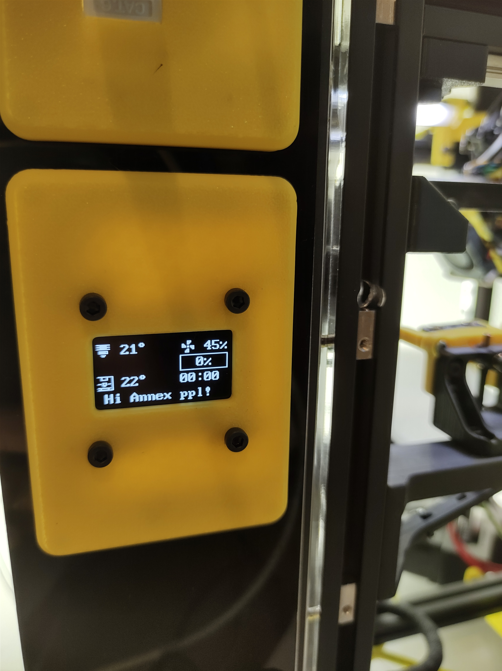
[picture p58: Printers/K3/Outdated/airox-blanking-plates/Images/screen-ssh1106-oled-1.3.jpg]
Printers/K3/Outdated/airox-blanking-plates/Images/screen-ssh1106-oled-1.3.jpg
